LostTime76/kicad_library/models/SAMTEC-CLP-110-02-X-X.step

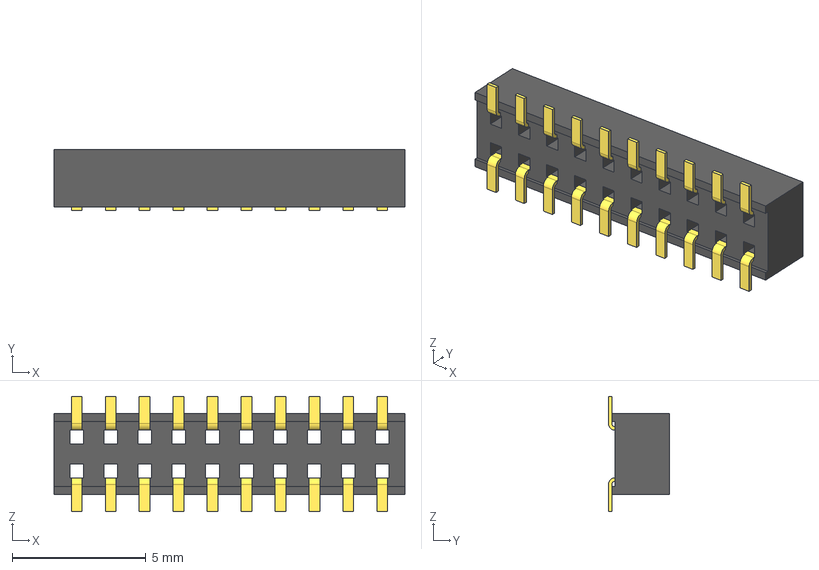
[picture p1: CAD file, 2026-06-20]
models/SAMTEC-CLP-110-02-X-X.step
13.1 x 2.29 x 4.32 mm
CLP-110-2-F-DTRM
C-106-22-1-F-10_Pin x 2
