LostTime76/kicad_library/models/SAMTEC-FTSH-120-X-X-DV.step

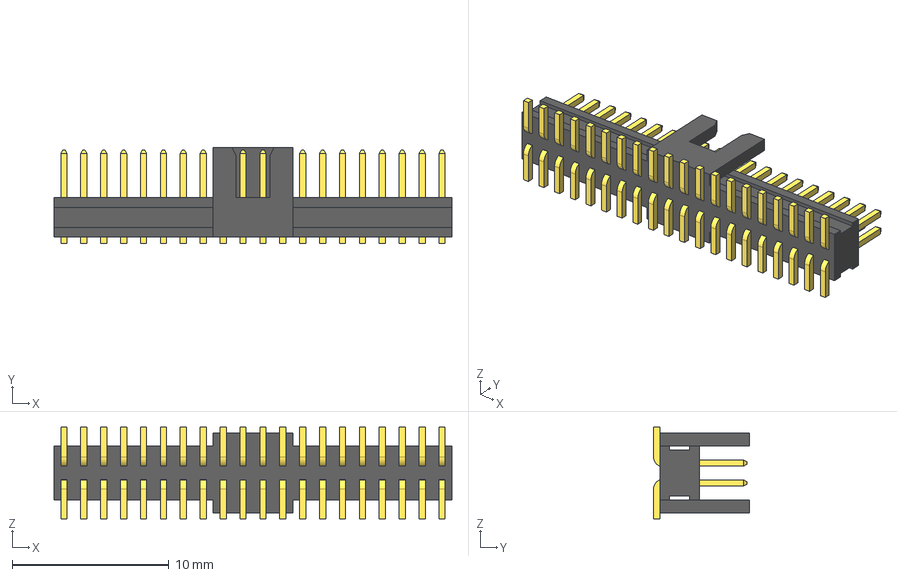
[picture p2: CAD file, 2026-05-26]
models/SAMTEC-FTSH-120-X-X-DV.step
25.4 x 6.12 x 5.84 mm
FTSH-120-01-L-DV-K-TR_body
FTSH-120-01-L-DV-K-TR_pins1
FTSH-120-01-L-DV-K-TR_pins2
