LostTime76/kicad_library/models/SAMTEC-FLE-110-X-X-DV.step

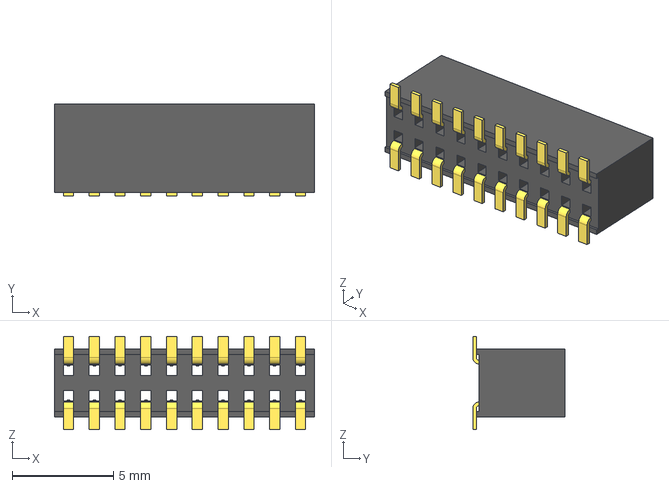
[picture p3: CAD file, 2026-05-17]
models/SAMTEC-FLE-110-X-X-DV.step
12.8 x 4.55 x 4.59 mm
FLE-110-01-DV_socket
C-96-01-10-DV
