LostTime76/kicad_library/models/TLP385.step

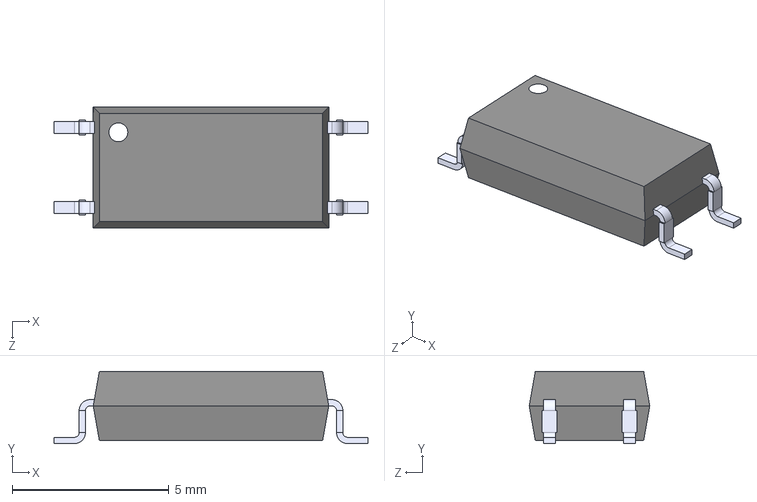
[picture p4: CAD file, 2026-05-17]
models/TLP385.step
10.0 x 2.30 x 3.84 mm
