LostTime76/kicad_library/models/WAGO-733-332.step

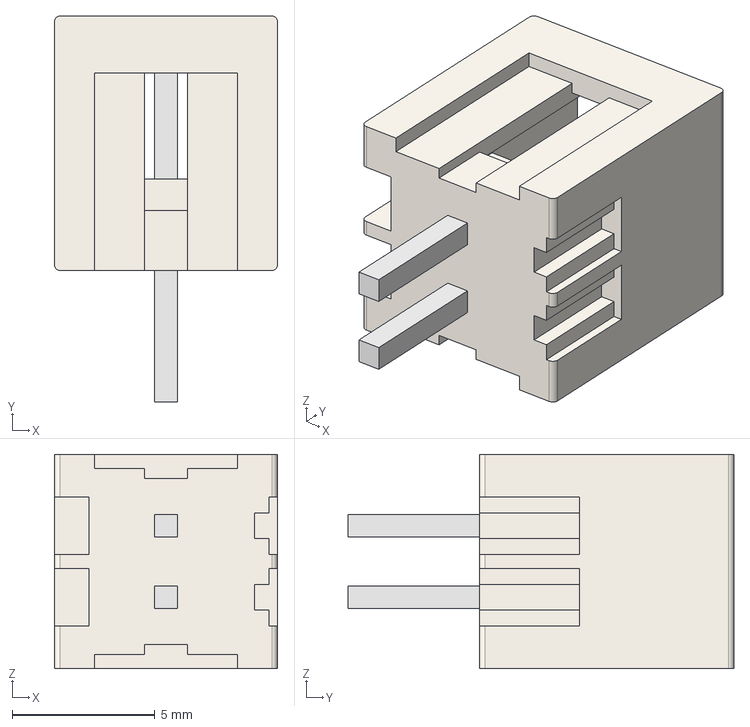
[picture p5: CAD file, 2026-05-17]
models/WAGO-733-332.step
7.80 x 13.5 x 7.50 mm
