LostTime76/kicad_library/models/SAMTEC-FTSH-105-X-X-DV.step

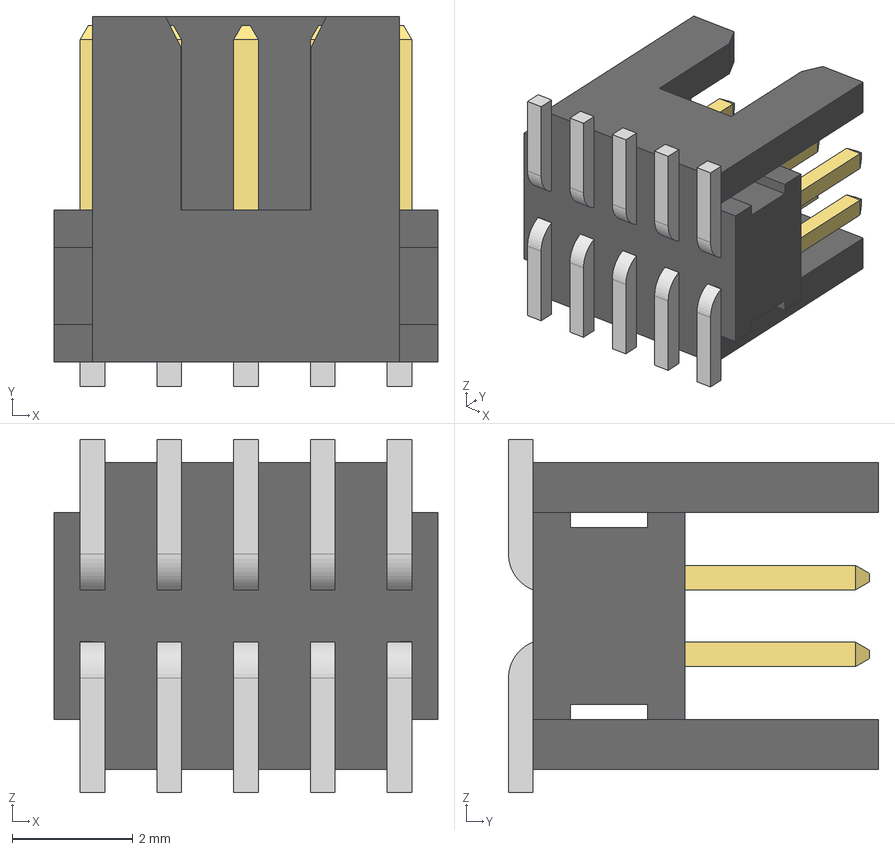
[picture p6: CAD file, 2026-05-17]
models/SAMTEC-FTSH-105-X-X-DV.step
6.35 x 6.12 x 5.84 mm
FTSH-105-01-L-DV-K-TR_body
FTSH-105-01-L-DV-K-TR_pins1
FTSH-105-01-L-DV-K-TR_pins2
