LostTime76/kicad_library/models/SAMTEC-FTSH-110-X-X-DV.step

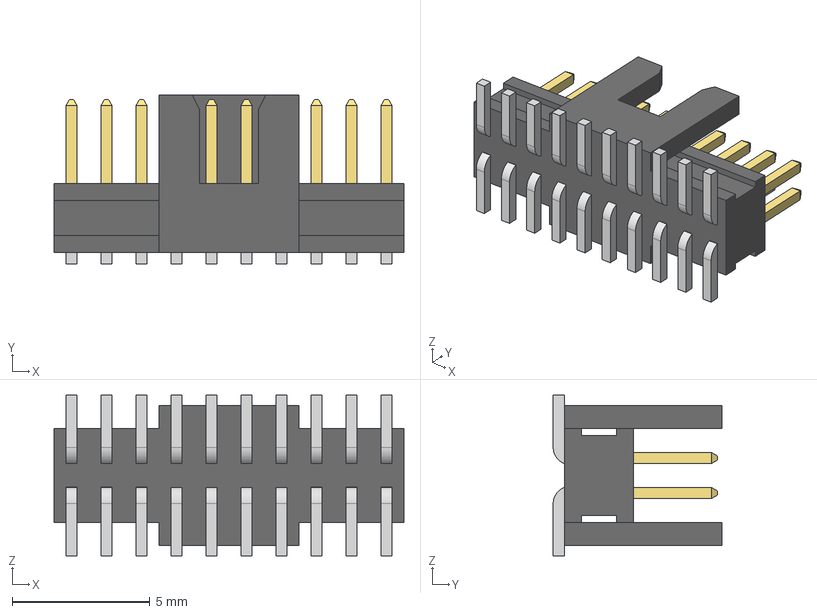
[picture p7: CAD file, 2026-05-17]
models/SAMTEC-FTSH-110-X-X-DV.step
12.7 x 6.12 x 5.84 mm
FTSH-110-01-L-DV-K-TR_body
FTSH-110-01-L-DV-K-TR_pins1
FTSH-110-01-L-DV-K-TR_pins2
