LostTime76/kicad_library/models/SFH11-PBPC-D10-RA-BK.step

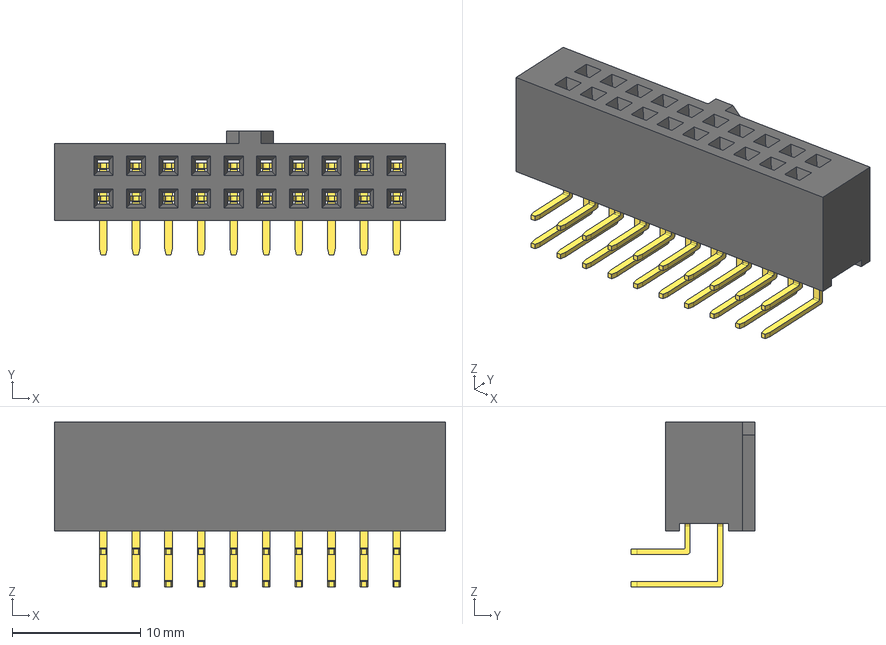
[picture p8: CAD file, 2026-05-17]
models/SFH11-PBPC-D10-RA-BK.step
30.5 x 9.70 x 12.8 mm
