LostTime76/kicad_library/models/JST-B04B-ZESK-1D.STEP

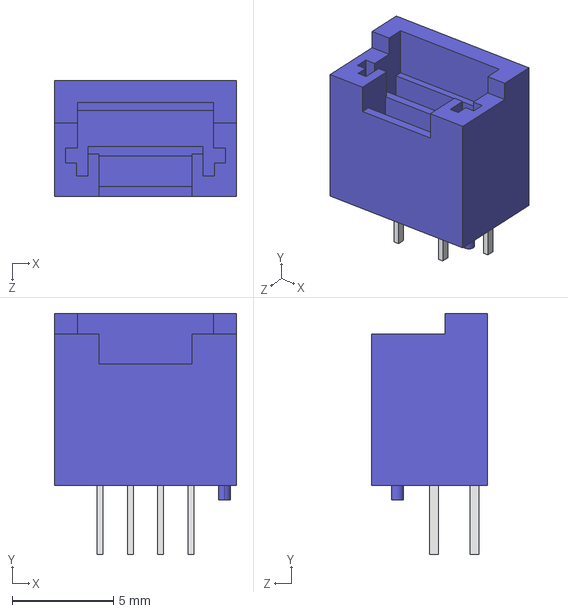
[picture p9: CAD file, 2026-03-16]
models/JST-B04B-ZESK-1D.STEP
9.00 x 11.9 x 5.75 mm
