LostTime76/kicad_library/models/JST-B02B-ZESK-1D.STEP

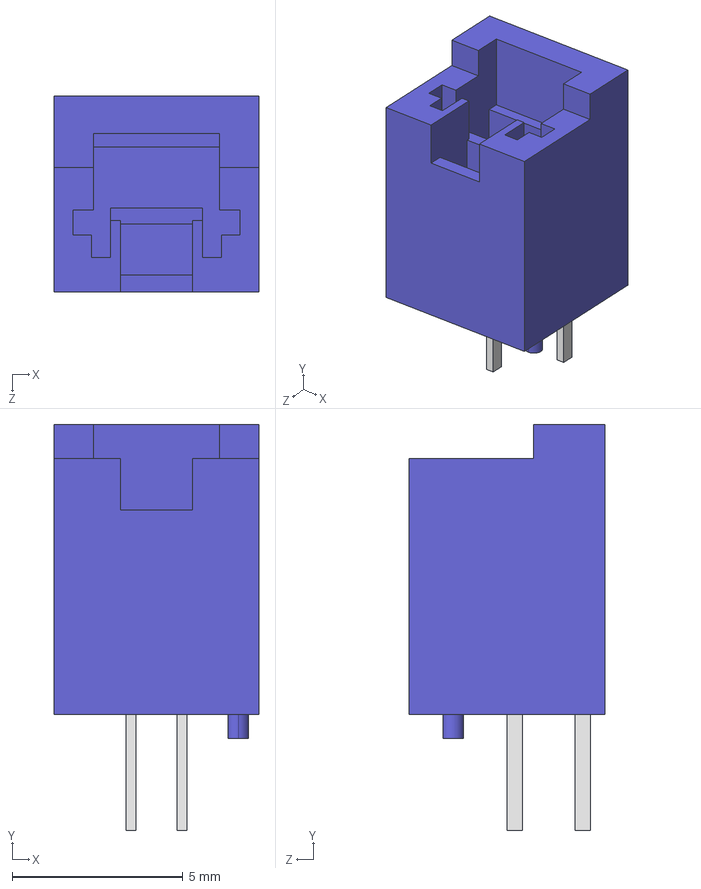
[picture p10: CAD file, 2026-03-16]
models/JST-B02B-ZESK-1D.STEP
6.00 x 11.9 x 5.75 mm
