LostTime76/kicad_library/models/TI-DP0028A.step

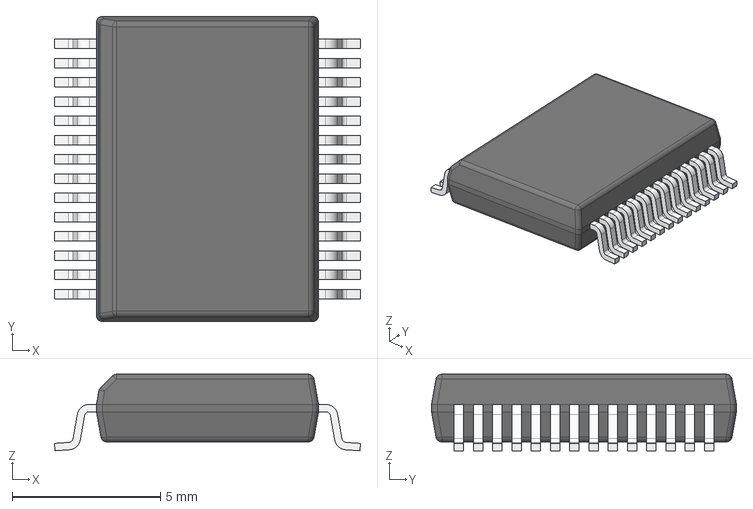
[picture p11: CAD file, 2026-03-16]
models/TI-DP0028A.step
10.3 x 10.3 x 2.59 mm
LEAD x 28
