LostTime76/kicad_library/models/WE-PPTI-1209.step

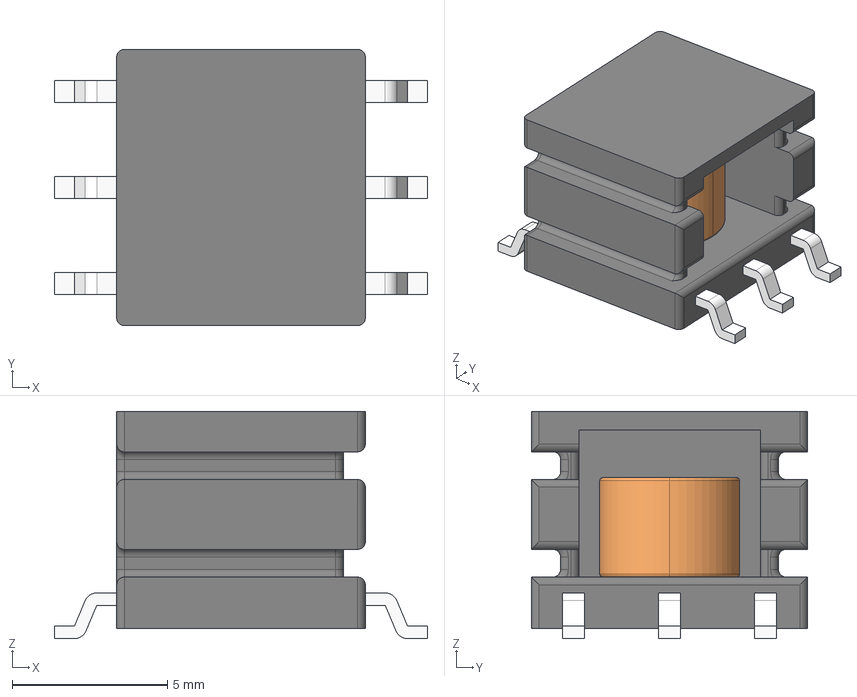
[picture p12: CAD file, 2026-03-16]
models/WE-PPTI-1209.step
12.0 x 8.89 x 7.31 mm
