LostTime76/kicad_library/models/WE-LHMI-4020.step

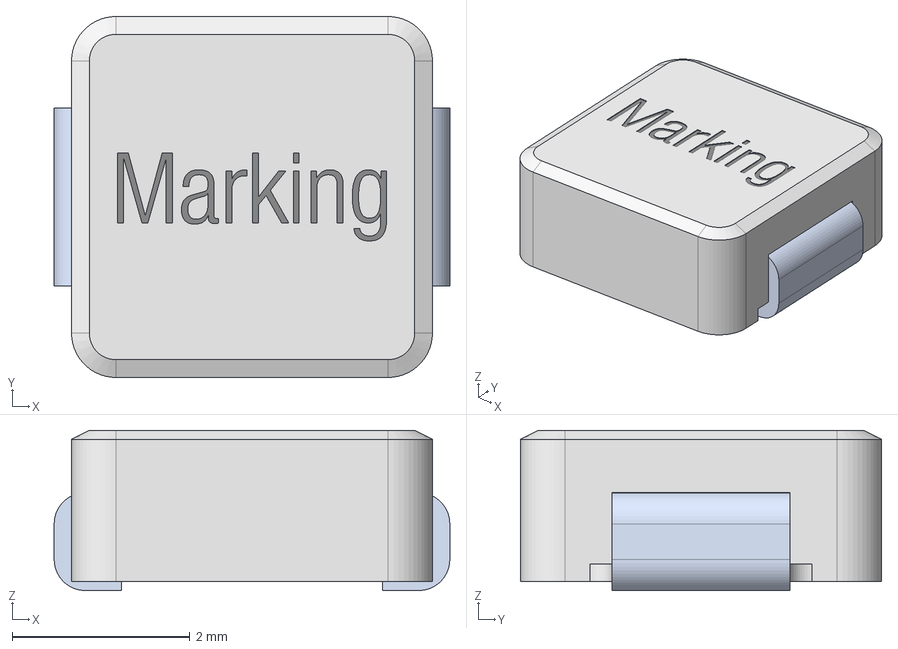
[picture p13: CAD file, 2026-03-16]
models/WE-LHMI-4020.step
4.45 x 4.06 x 1.80 mm
