LostTime76/kicad_library/models/GCT-USB4110.STEP

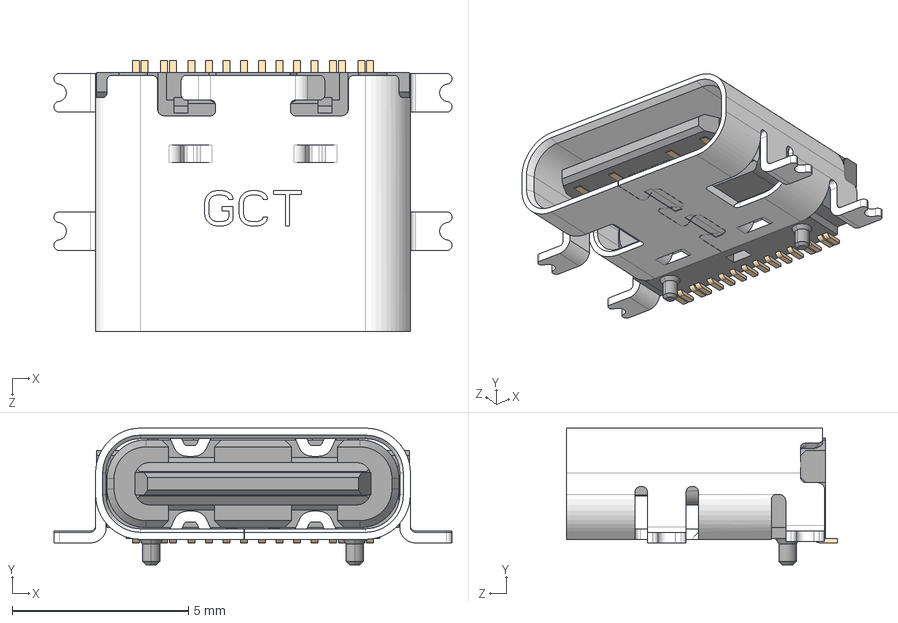
[picture p14: CAD file, 2026-03-16]
models/GCT-USB4110.STEP
11.3 x 3.89 x 7.70 mm
